f14eagle/redox-keyboard/redox-f14/#test.dxf

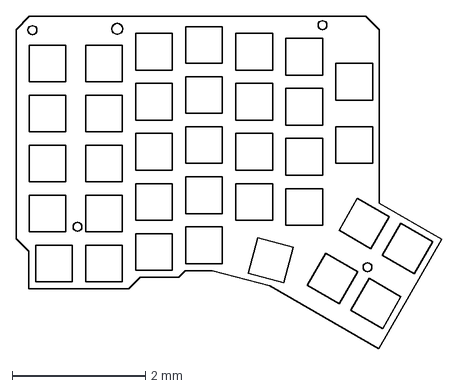
[picture p1: CAD file, 2019-10-26]
redox-f14/#test.dxf
6.38 x 4.98 mm
