f14eagle/redox-keyboard/redox-f14/case/#wingxx-case-rev2.dxf

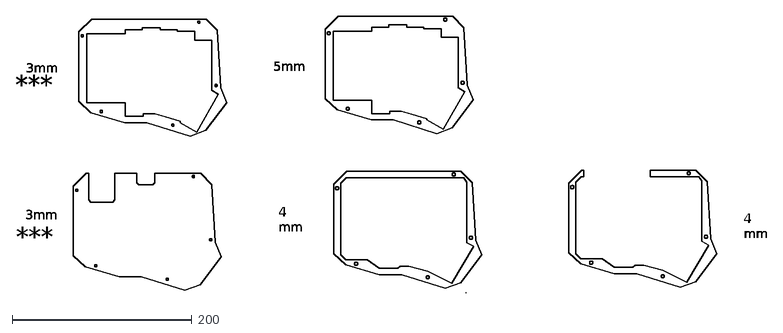
[picture p2: CAD file, 2020-09-10]
redox-f14/case/#wingxx-case-rev2.dxf
3mm
4 mm
5mm
***
