f14eagle/redox-keyboard/redox-f14/pcb/redox_w_transmitters_kicad_files/dxf/redox_rev1_case_v2_l1-Edge_Cuts.dxf

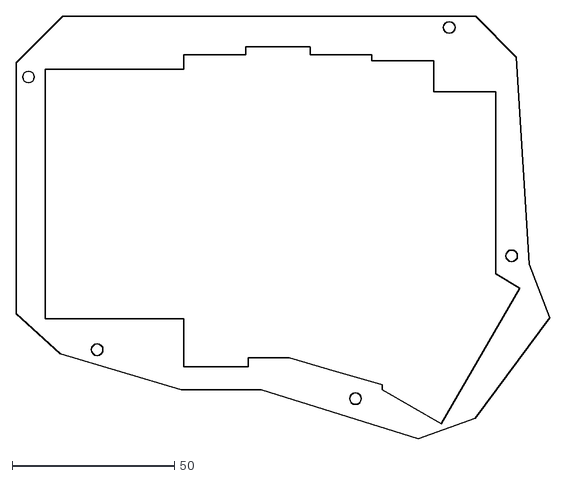
[picture p3: CAD file, 2020-03-04]
redox-f14/pcb/redox_w_transmitters_kicad_files/dxf/redox_rev1_case_v2_l1-Edge_Cuts.dxf
164.3 x 130.2
