f14eagle/redox-keyboard/redox-f14/pcb/wingxx_receiver_kicad_files_v3/dxf/wing-receiver-lite-case-Edge_Cuts.dxf

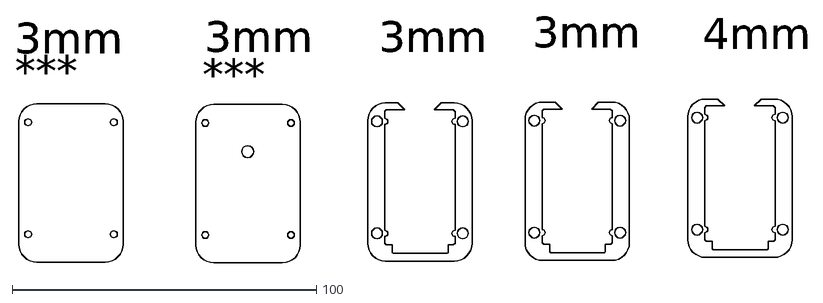
[picture p4: CAD file, 2020-09-10]
redox-f14/pcb/wingxx_receiver_kicad_files_v3/dxf/wing-receiver-lite-case-Edge_Cuts.dxf
4mm
3mm
***
