f14eagle/redox-keyboard/redox-f14/case/wingpad-case-v4.dxf

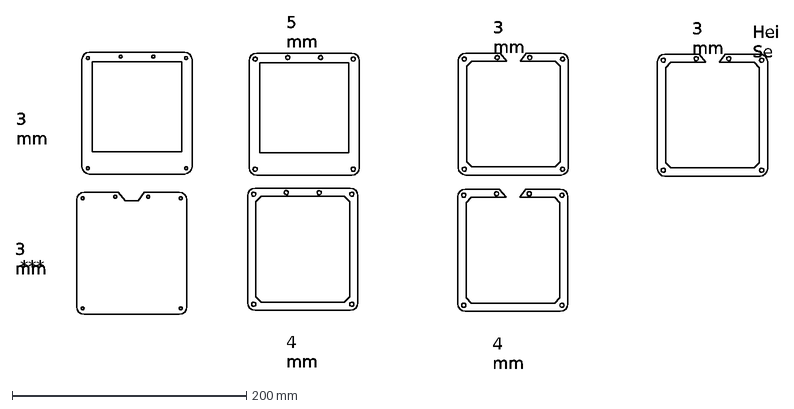
[picture p5: CAD file, 2020-05-10]
redox-f14/case/wingpad-case-v4.dxf
3 mm
5 mm
4 mm
***
Hei Se
