f14eagle/redox-keyboard/redox-f14/pcb/redox_w_transmitters_kicad_files/dxf/redox_rev1_case_l1-Edge_Cuts.dxf

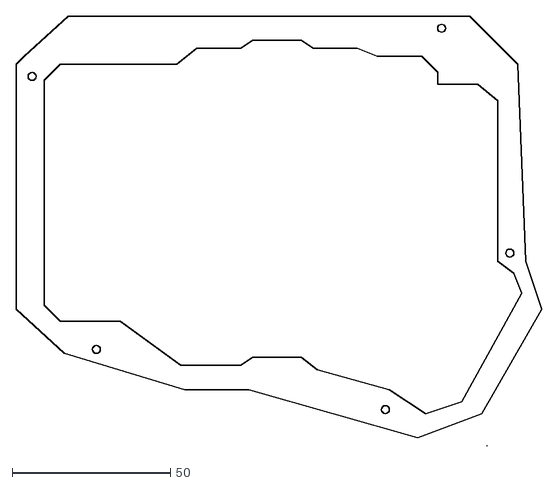
[picture p8: CAD file, 2020-02-07]
redox-f14/pcb/redox_w_transmitters_kicad_files/dxf/redox_rev1_case_l1-Edge_Cuts.dxf
166.4 x 135.9
