f14eagle/redox-keyboard/redox-f14/pcb/wingxx_receiver_kicad_files_v3/dxf/wingxx_rev3-final-case-0.4.dxf

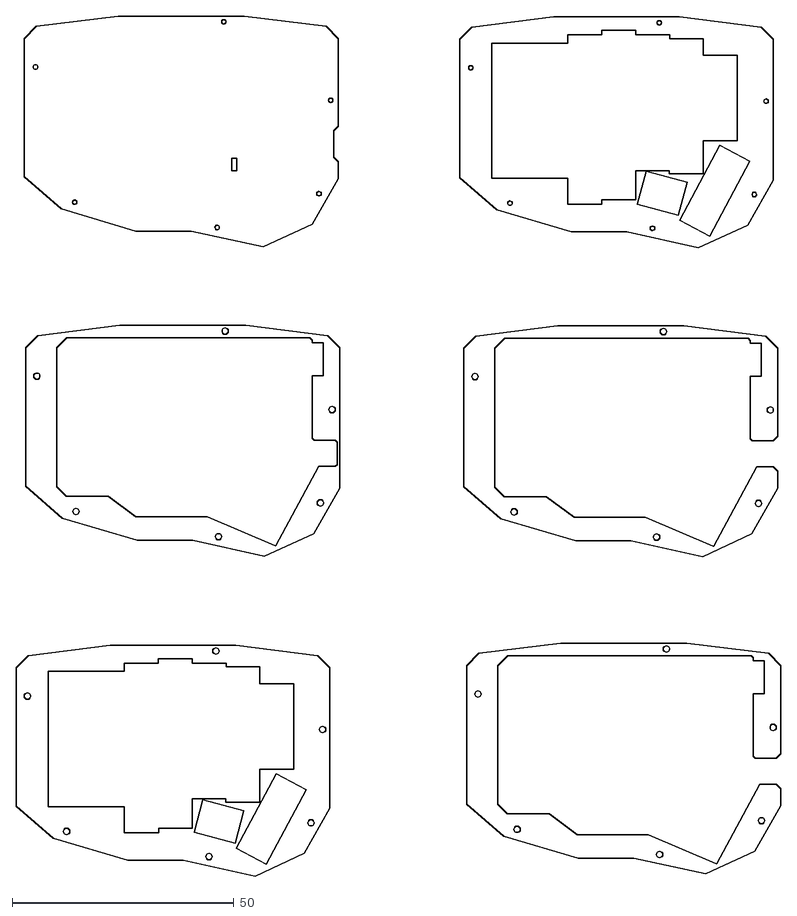
[picture p9: CAD file, 2020-05-10]
redox-f14/pcb/wingxx_receiver_kicad_files_v3/dxf/wingxx_rev3-final-case-0.4.dxf
172.4 x 193.8
