f14eagle/redox-keyboard/redox-f14/case/##wingpad-case-v2.dxf

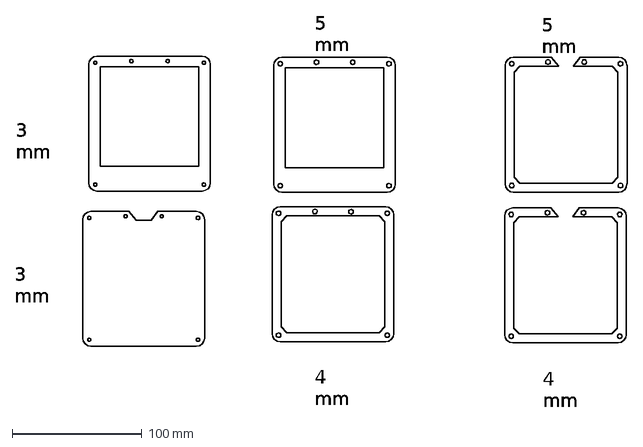
[picture p10: CAD file, 2020-03-12]
redox-f14/case/##wingpad-case-v2.dxf
3 mm
5 mm
4 mm
