f14eagle/redox-keyboard/redox-f14/pcb/wingxx_receiver_kicad_files_v3/dxf/wingxx_rev3-final-case.dxf

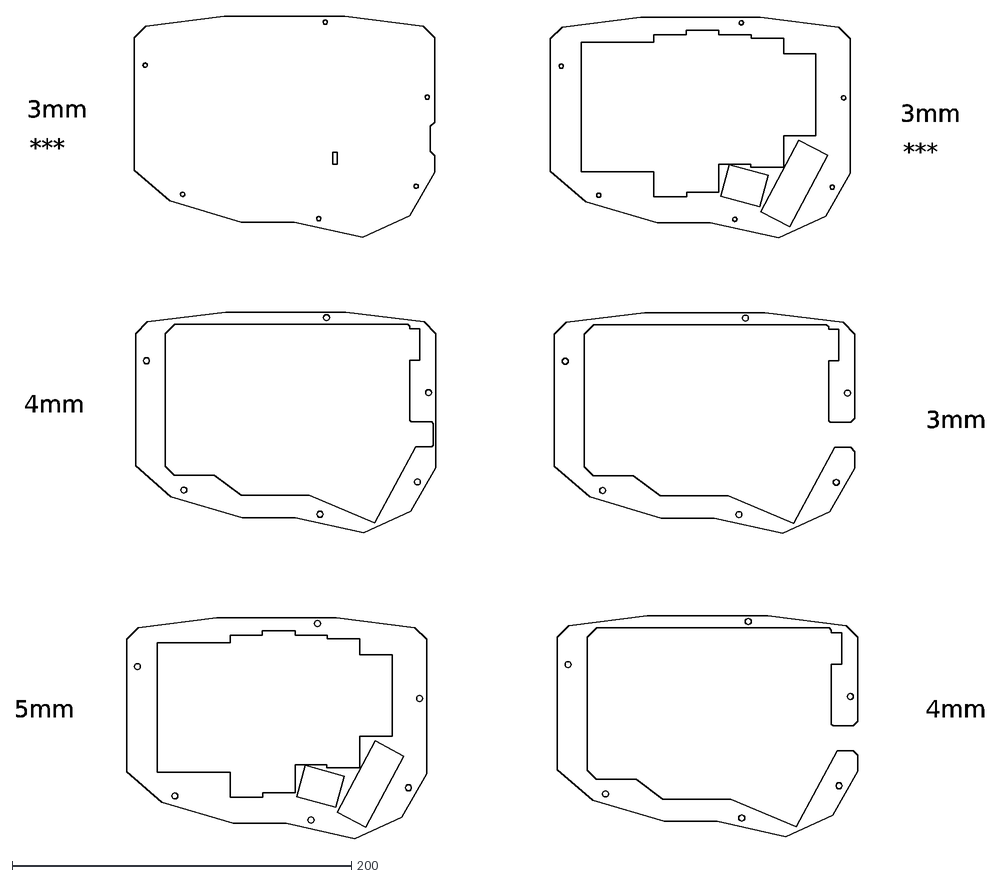
[picture p11: CAD file, 2020-05-10]
redox-f14/pcb/wingxx_receiver_kicad_files_v3/dxf/wingxx_rev3-final-case.dxf
3mm
5mm
4mm
***
