f14eagle/redox-keyboard/redox-f14/case/#wingpad-plate-v2.dxf

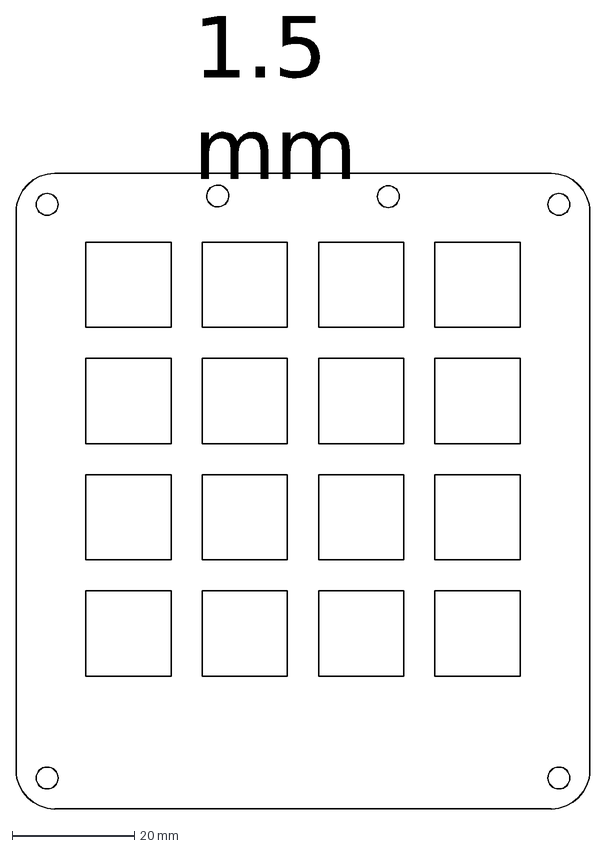
[picture p12: CAD file, 2020-02-28]
redox-f14/case/#wingpad-plate-v2.dxf
1.5 mm
