f14eagle/redox-keyboard/redox-f14/pcb/wingxx_receiver_kicad_files_v3/dxf/wingxx_rev3-final-case-0.3.dxf

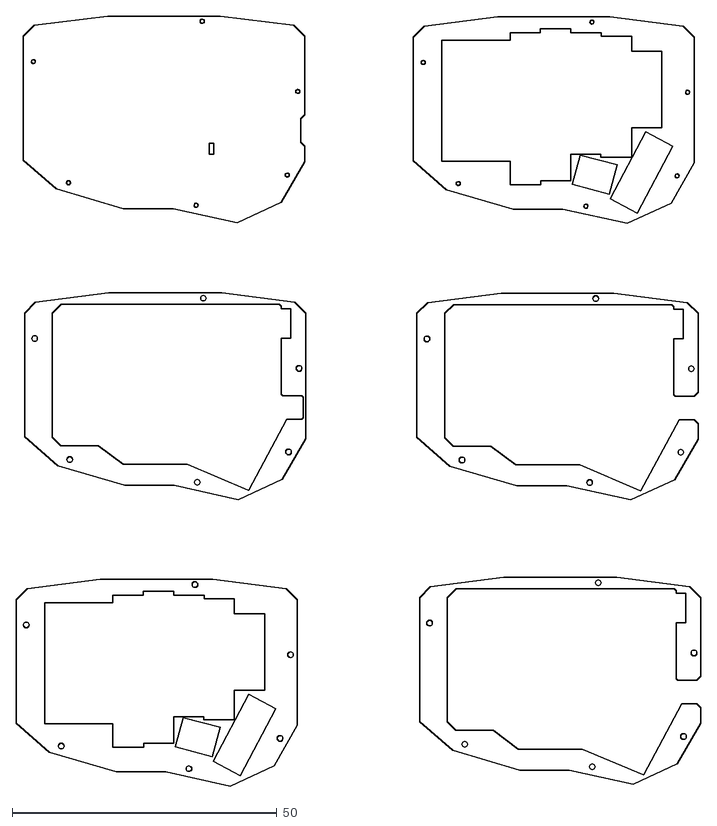
[picture p13: CAD file, 2020-05-10]
redox-f14/pcb/wingxx_receiver_kicad_files_v3/dxf/wingxx_rev3-final-case-0.3.dxf
129.3 x 145.4
