f14eagle/redox-keyboard/redox-f14/case/case-v2-l3-1.dxf

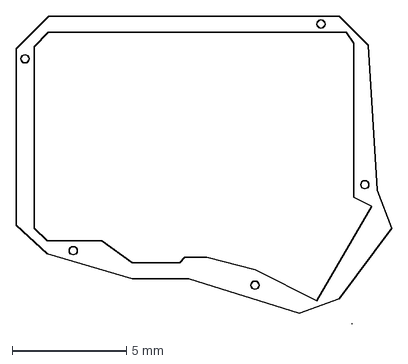
[picture p14: CAD file, 2019-12-29]
redox-f14/case/case-v2-l3-1.dxf
16.4 x 13.5 mm
