f14eagle/redox-keyboard/redox-f14/case/wingxx-plate.dxf

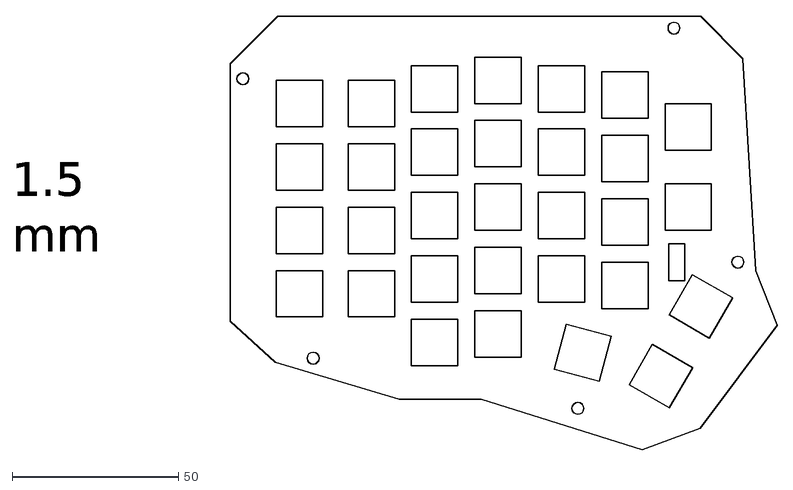
[picture p15: CAD file, 2019-12-29]
redox-f14/case/wingxx-plate.dxf
1.5 mm
