f14eagle/redox-keyboard/redox-f14/case/case-v2-l2.dxf

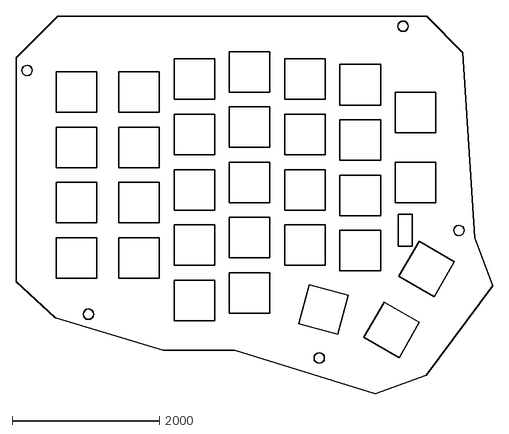
[picture p16: CAD file, 2019-11-02]
redox-f14/case/case-v2-l2.dxf
6468.7 x 5125.0
