f14eagle/redox-keyboard/redox-f14/case/case-v2-l1.dxf

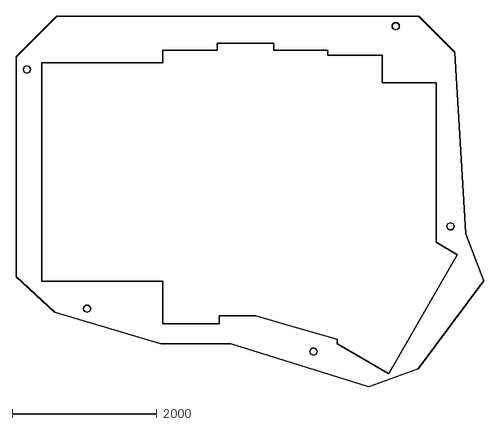
[picture p17: CAD file, 2019-11-02]
redox-f14/case/case-v2-l1.dxf
6468.7 x 5125.0
