f14eagle/redox-keyboard/redox-f14/case/f14-case-v2.dxf

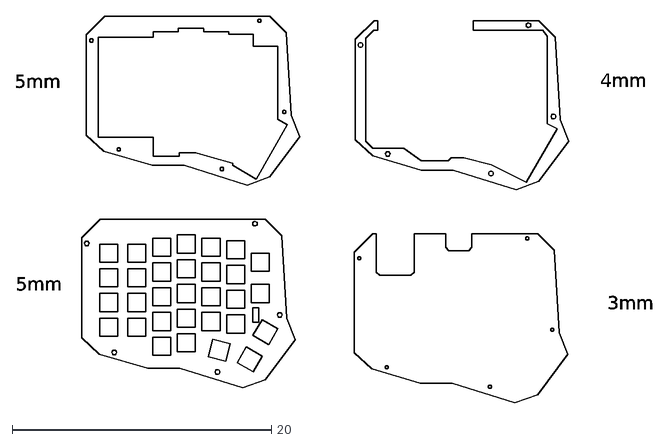
[picture p19: CAD file, 2019-11-02]
redox-f14/case/f14-case-v2.dxf
5mm
4mm
3mm
