f14eagle/redox-keyboard/redox-f14/case/#f14-case.dxf

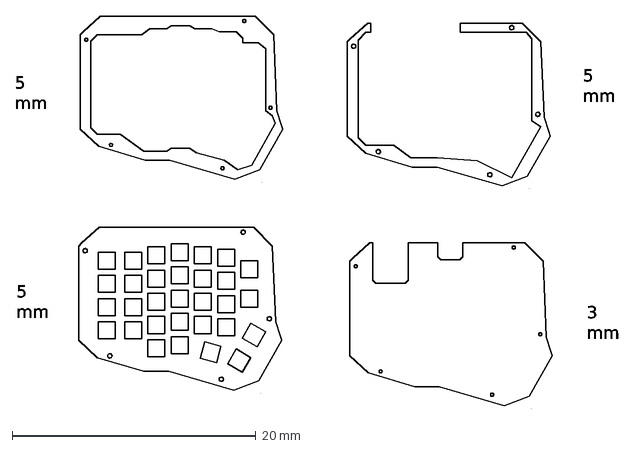
[picture p21: CAD file, 2019-11-02]
redox-f14/case/#f14-case.dxf
5 mm
3 mm
