f14eagle/redox-keyboard/redox-f14/case/RedoxWirelessRev1BottomLeft.STL

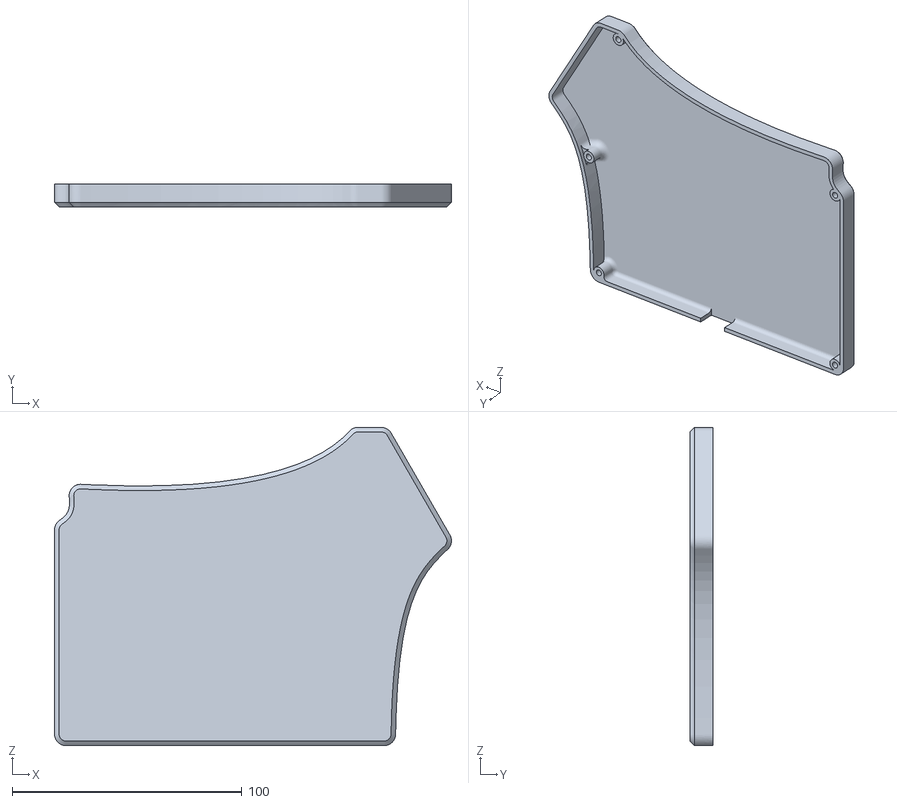
[picture p22: CAD file, 2019-10-26]
redox-f14/case/RedoxWirelessRev1BottomLeft.STL
172.6 x 10.0 x 138.4
