f14eagle/redox-keyboard/redox-f14/case/RedoxWirelessRev1TopLeft.STL

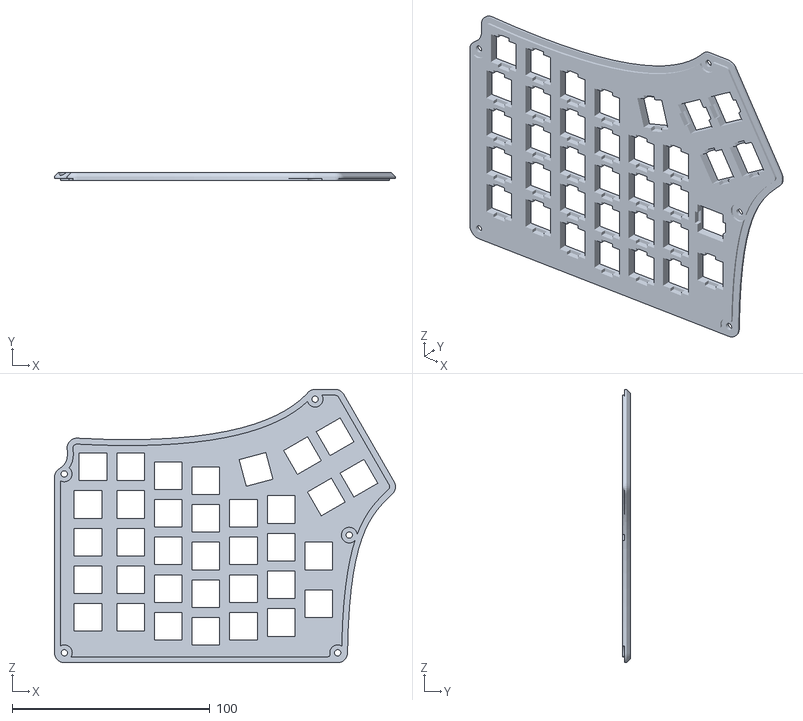
[picture p23: CAD file, 2019-10-26]
redox-f14/case/RedoxWirelessRev1TopLeft.STL
172.6 x 4.00 x 138.4
