f14eagle/redox-keyboard/(list of files, cad)

Other CAD files:
redox-f14/case/wingxx-case-ykl.dxf
redox-f14/case/RedoxWirelessRev1BottomRight.STL
redox-f14/case/RedoxWirelessRev1TopRight.STL
redox-f14/case/#wingpad-case-v2.dxf
redox-f14/case/case-l1.dxf
redox-f14/case/case-l2.dxf
redox-f14/case/case-l3.dxf
redox-f14/case/case-l4.dxf
redox-f14/case/f14-case.dxf
redox-f14/case/wingpad-case-v3.dxf
redox-f14/case/wingpad-plate-v2.dxf
redox-f14/case/wingxx-case-rev2.dxf
redox-f14/case/wingxx-case.dxf
redox-f14/pcb/wingxx_receiver_kicad_files/case/#wingpad-case.dxf
redox-f14/pcb/wingxx_receiver_kicad_files/case/wingpad-case.dxf
redox-f14/pcb/wingxx_receiver_kicad_files_v2.5/dxf/wing-receiver-lite-case-Edge_Cuts.dxf
redox-f14/pcb/wingxx_receiver_kicad_files_v2/case/#wingpad-case.dxf
redox-f14/pcb/wingxx_receiver_kicad_files_v2/case/wingpad-case.dxf
redox-f14/pcb/wingxx_receiver_kicad_files_v2/dxf/#wingxx-receiver-case-v4-plate.dxf
redox-f14/pcb/wingxx_receiver_kicad_files_v2/dxf/wingxx-receiver-case-v4-Edge_Cuts.dxf
redox-f14/pcb/wingxx_receiver_kicad_files_v2/dxf/wingxx-receiver-case-v4-case-bottom.dxf
redox-f14/pcb/wingxx_receiver_kicad_files_v2/dxf/wingxx-receiver-case-v4-case.dxf
redox-f14/pcb/wingxx_receiver_kicad_files_v2/dxf/wingxx-receiver-case-v4-case2.dxf
redox-f14/pcb/wingxx_receiver_kicad_files_v2/dxf/wingxx-receiver-case-v4-case3.dxf
redox-f14/pcb/wingxx_receiver_kicad_files_v2/dxf/wingxx-receiver-case-v4-case4.dxf
redox-f14/pcb/wingxx_receiver_kicad_files_v2/dxf/wingxx-receiver-case-v4-plate.dxf
redox-f14/pcb/wingxx_receiver_kicad_files_v2/dxf/wingxx-receiver-case-v4-plate2.dxf
redox-f14/test.dxf
