f14eagle/redox-keyboard/(list of files, drawings)

Other design files:
redox-f14/pcb/redox_w_transmitters_kicad_files/redox_rev1.dsn
redox-f14/pcb/wingxx_receiver_kicad_files/redox-receiver.dsn
redox-f14/pcb/wingxx_receiver_kicad_files_v2.5/wing-receiver-lite-rev2.dsn
redox-f14/pcb/wingxx_receiver_kicad_files_v2.5/wing-receiver-lite.dsn
redox-f14/pcb/wingxx_receiver_kicad_files_v2/redox-receiver.dsn
redox-f14/pcb/wingxx_receiver_kicad_files_v2/wingxx-receiver-v3.dsn
redox-f14/pcb/wingxx_receiver_kicad_files_v2/wingxx-receiver-v4.dsn
redox-f14/pcb/wingxx_receiver_kicad_files_v3/wing-receiver-lite.dsn
