f14eagle/redox-keyboard/redox-f14/pcb/wingxx_receiver_kicad_files_v2.5/wing-receiver-lite-rev2.kicad_pcb

## KiCad design redox-f14/pcb/wingxx_receiver_kicad_files_v2.5/wing-receiver-lite-rev2.kicad_pcb (2020-09-10, an earlier design)

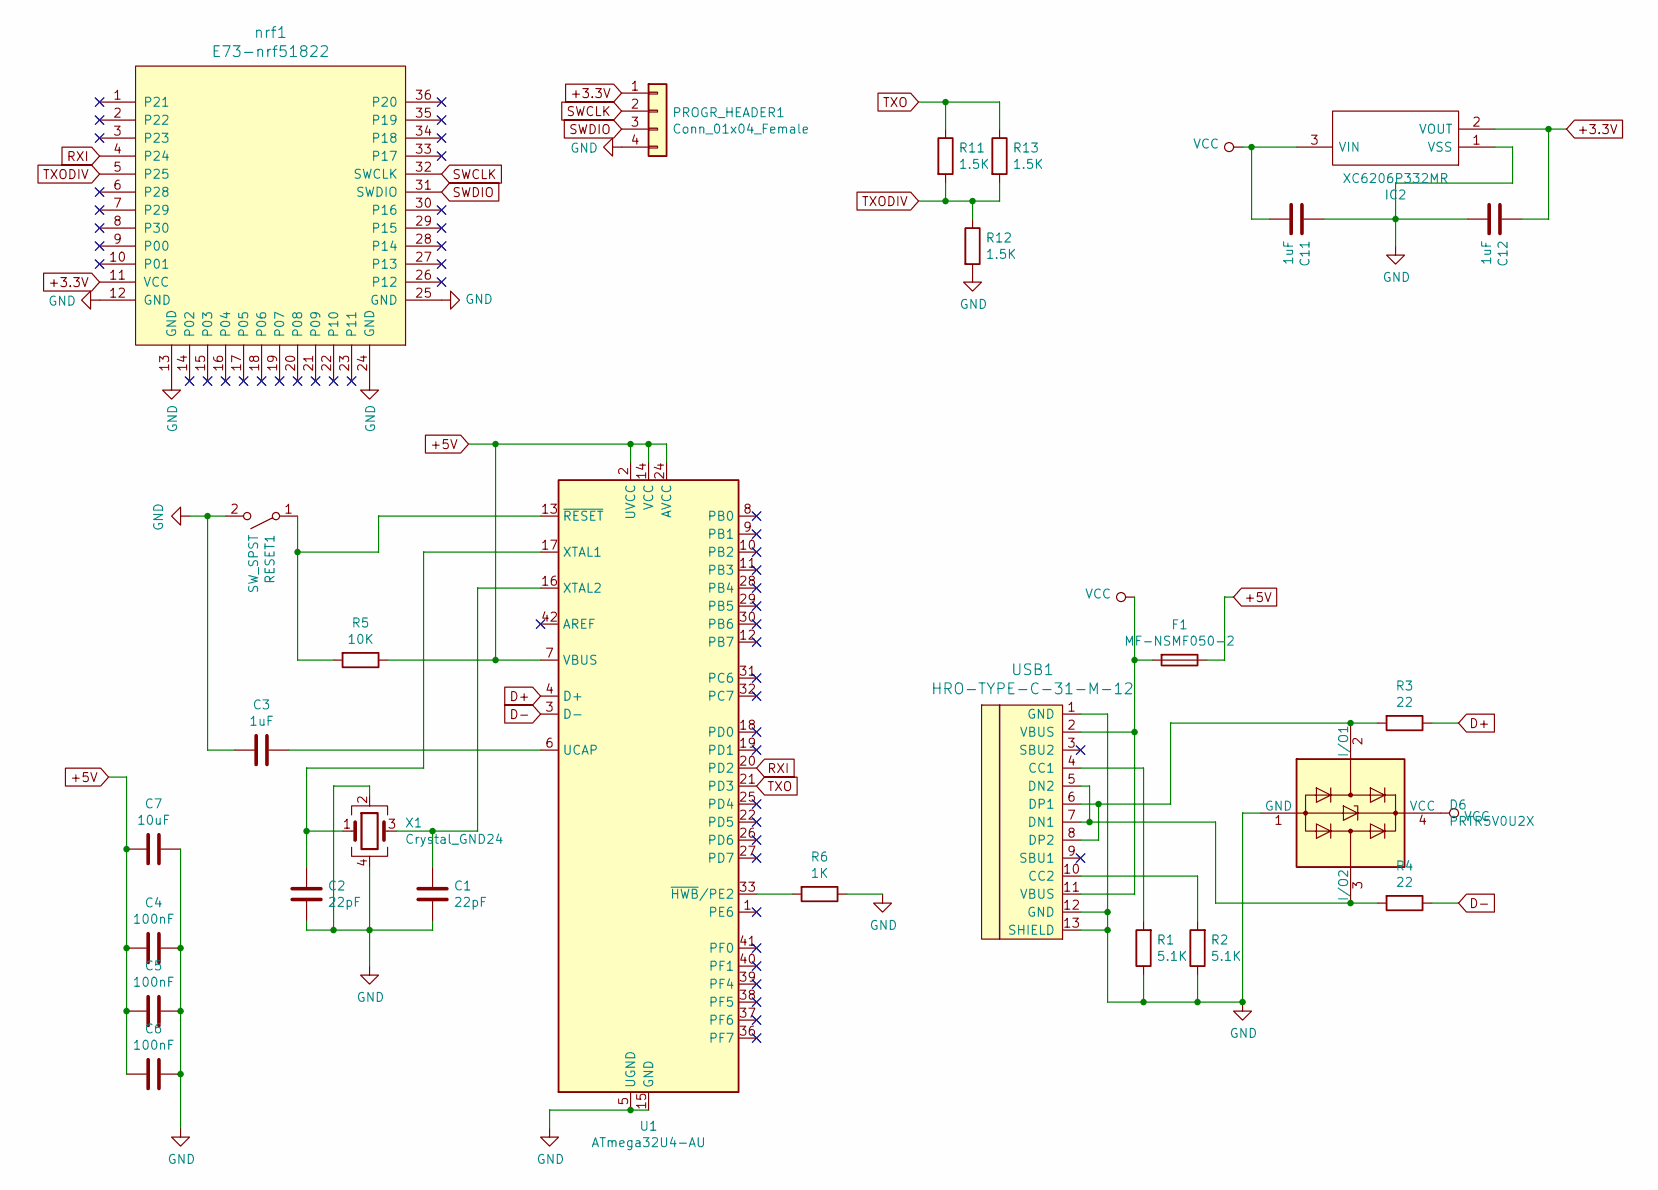
[picture p24: schematic wing-receiver-lite-rev2.sch, WingXX Receiver]

Parts:
C1, C2: 22pF; C_0805_2012Metric_Pad1.15x1.40mm_HandSolder
C3, C11, C12: 1uF; C_0805_2012Metric_Pad1.15x1.40mm_HandSolder
C4, C5, C6: 100nF; C_0805_2012Metric_Pad1.15x1.40mm_HandSolder
C7: 10uF; C_0805_2012Metric_Pad1.15x1.40mm_HandSolder
D6: PRTR5V0U2X; SOT-143
F1: MF-NSMF050-2; Fuse_1206_3216Metric_Pad1.42x1.75mm_HandSolder
IC2: XC6206P332MR; SOT95P280X130-3N; Manufacturer_Part_Number XC6206P332MR
PROGR_HEADER1: Conn_01x04_Female; PinHeader_1x04_P2.54mm_Vertical
R1, R2: 5.1K; R_0805_2012Metric_Pad1.15x1.40mm_HandSolder
R3, R4: 22; R_0805_2012Metric_Pad1.15x1.40mm_HandSolder
R5: 10K; R_0805_2012Metric_Pad1.15x1.40mm_HandSolder
R6: 1K; R_0805_2012Metric_Pad1.15x1.40mm_HandSolder
R11, R12, R13: 1.5K; R_0805_2012Metric_Pad1.15x1.40mm_HandSolder
RESET1: SW_SPST; SW_SPST_CK_RS282G05A3
U1: ATmega32U4-AU; TQFP-44_10x10mm_P0.8mm
USB1: HRO-TYPE-C-31-M-12; HRO-TYPE-C-f14
X1: Crystal_GND24; Crystal_SMD_3225-4Pin_3.2x2.5mm_HandSoldering
nrf1: E73-nrf51822; E73-nrf51822-Module

Connections:
+3.3V: C12.1, IC2.2 (VOUT), PROGR_HEADER1.1, nrf1.11 (VCC)
+5V: C4.2, C5.2, C6.2, C7.2, F1.1, R5.1, U1.2 (UVCC), U1.7 (VBUS), U1.14 (VCC), U1.24 (AVCC), U1.34 (VCC), U1.44 (AVCC)
D+: R3.1, U1.4 (D+)
D-: R4.1, U1.3 (D-)
GND: C1.2, C2.2, C3.2, C4.1, C5.1, C6.1, C7.1, C11.1, C12.2, D6.1 (GND), IC2.1 (VSS), PROGR_HEADER1.4, R1.1, R2.1, R6.1, R12.2, RESET1.2 (B), U1.5 (UGND), U1.15 (GND), U1.23 (GND), U1.35 (GND), U1.43 (GND), USB1.1 (GND), USB1.12 (GND), USB1.13 (SHIELD), X1.2, X1.4, nrf1.12 (GND), nrf1.13 (GND), nrf1.24 (GND), nrf1.25 (GND)
unnamed: C1.1, U1.16 (XTAL2), X1.3
unnamed: C2.1, U1.17 (XTAL1), X1.1
unnamed: C3.1, U1.6 (UCAP)
unnamed: D6.2 (I/O1), R3.2, USB1.6 (DP1), USB1.8 (DP2)
unnamed: D6.3 (I/O2), R4.2, USB1.5 (DN2), USB1.7 (DN1)
unnamed: R1.2, USB1.4 (CC1)
unnamed: R2.2, USB1.10 (CC2)
unnamed: R5.2, RESET1.1 (A), U1.13 (~RESET)
unnamed: R6.2, U1.33 (~HWB~/PE2)
RXI: U1.20 (PD2), nrf1.4 (P24)
SWCLK: PROGR_HEADER1.2, nrf1.32 (SWCLK)
SWDIO: PROGR_HEADER1.3, nrf1.31 (SWDIO)
TXO: R11.1, R13.1, U1.21 (PD3)
TXODIV: R11.2, R12.1, R13.2, nrf1.5 (P25)
VCC: C11.2, D6.4 (VCC), F1.2, IC2.3 (VIN), USB1.2 (VBUS), USB1.11 (VBUS)

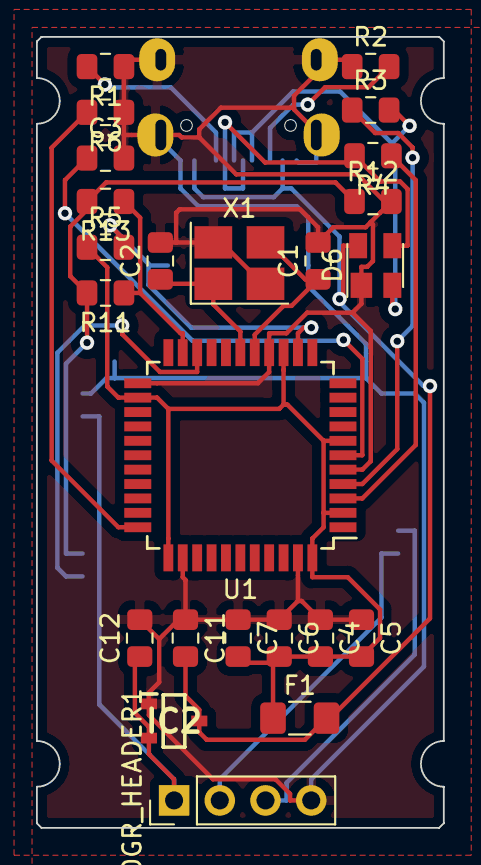
[picture p25: board wing-receiver-lite-rev2.kicad_pcb from above]

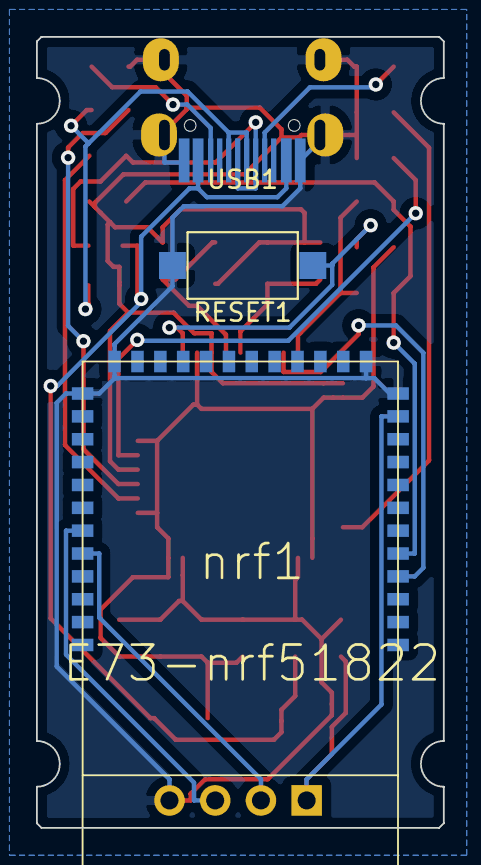
[picture p26: board wing-receiver-lite-rev2.kicad_pcb from below]

Board: 2 copper layers, 22.6 x 43.9 mm, 27 parts (3 on the bottom side), 20 nets.
