f14eagle/redox-keyboard/redox-w/pcb/redox_w_transmitters_kicad_files/redox_rev1.kicad_pcb

## KiCad design redox-w/pcb/redox_w_transmitters_kicad_files/redox_rev1.kicad_pcb (2019-10-26)

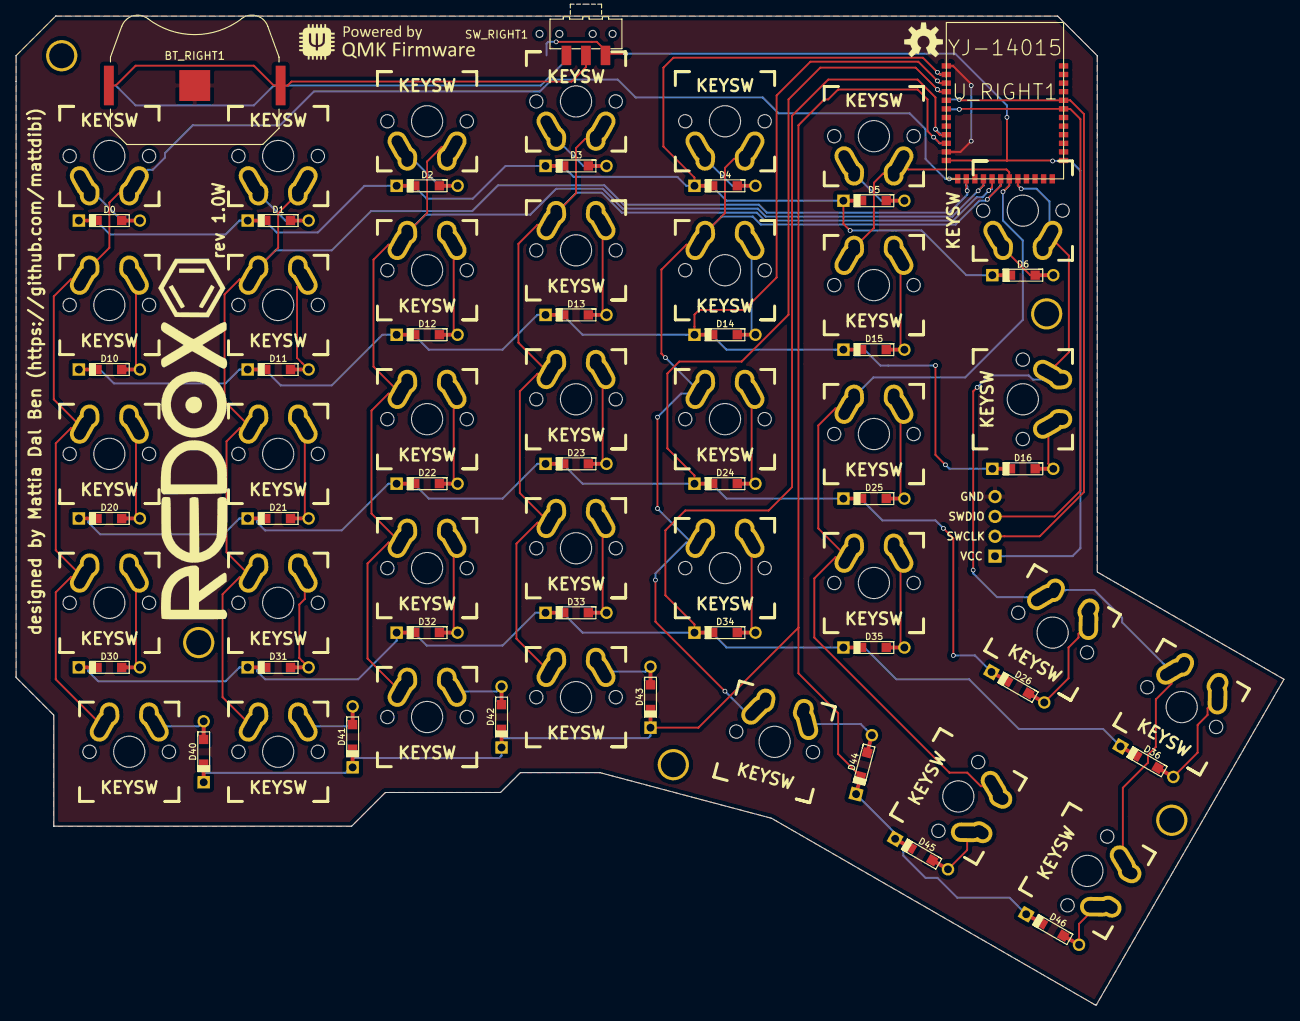
[picture p27: board redox_rev1.kicad_pcb from above]

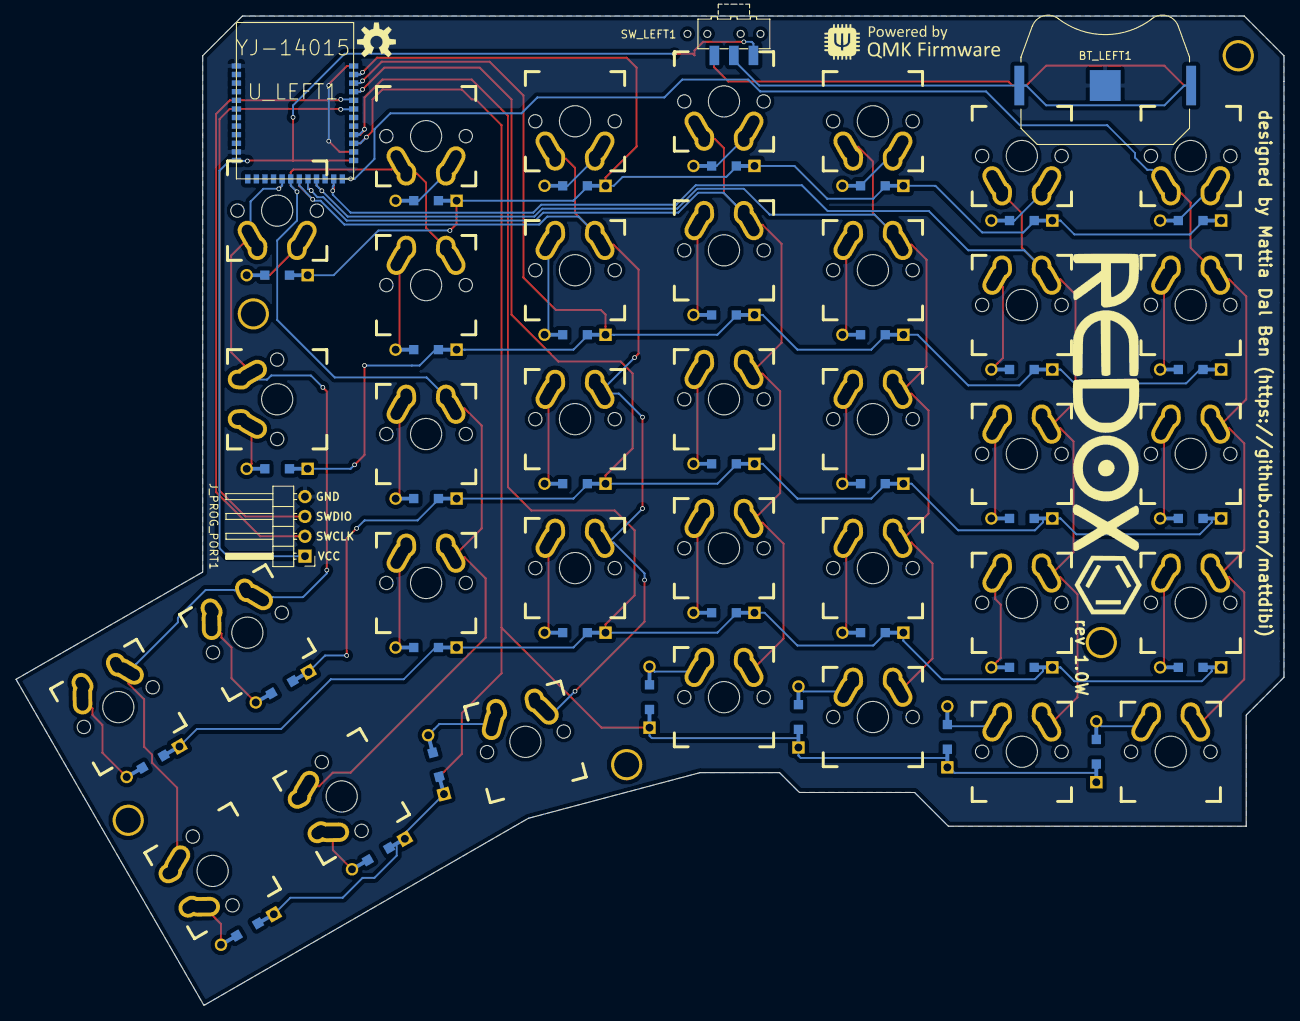
[picture p28: board redox_rev1.kicad_pcb from below]

Board: 2 copper layers, 162.2 x 126.5 mm, 82 parts (4 on the bottom side), 53 nets.

Parts:
BT_LEFT1: Battery_Cell; BatteryHolder_Keystone_3034_1x20mm
BT_RIGHT1: Battery_Cell; BatteryHolder_Keystone_3034_1x20mm
D0, D1, D2, D3, D4, D5, D6, D10, D11, D12, D13, D14, D15, D16, D20, D21, D22, D23, D24, D25, D26, D30, D31, D32, D33, D34, D35, D36, D40, D41, D42, D43, D44, D45, D46: D; Diode-dual
HOLE_M3, HOLE_M3#2, HOLE_M3#3, HOLE_M3#4, HOLE_M3#5: VAL**; HOLE_M3
J_PROG_PORT1: Conn_01x04_Male; PinHeader_1x04_P2.54mm_Horizontal
K0, K10, K20, K30, K44: KEYSW; Mx_Alps_125-dualside
K1, K2, K3, K4, K5, K6, K11, K12, K13, K14, K15, K21, K22, K23, K24, K25, K26, K31, K32, K33, K34, K35, K36, K40, K41, K42, K43: KEYSW; Mx_Alps_100-dualside
K16, K45, K46: KEYSW; Mx_Alps_150-dualsided
SW_LEFT1: SW_SPDT; SW_SPDT_CK-JS102011SAQN
SW_RIGHT1: SW_SPDT; SW_SPDT_CK-JS102011SAQN
U_LEFT1: YJ-14015; MY-YJ-14015-Module
U_RIGHT1: YJ-14015; MY-YJ-14015-Module

Connections:
GND: BT_LEFT1.2, BT_RIGHT1.2, J_PROG_PORT1.4, U_LEFT1.1, U_LEFT1.11, U_RIGHT1.1, U_RIGHT1.11
unnamed: BT_LEFT1.1, SW_LEFT1.2
unnamed: BT_RIGHT1.1, SW_RIGHT1.2
unnamed: D0.2, K0.2
unnamed: D1.2, K1.2
unnamed: D2.2, K2.2
unnamed: D3.2, K3.2
unnamed: D4.2, K4.2
unnamed: D5.2, K5.2
unnamed: D6.2, K6.2
unnamed: D10.2, K10.2
unnamed: D11.2, K11.2
unnamed: D12.2, K12.2
unnamed: D13.2, K13.2
unnamed: D14.2, K14.2
unnamed: D15.2, K15.2
unnamed: D16.2, K16.2
unnamed: D20.2, K20.2
unnamed: D21.2, K21.2
unnamed: D22.2, K22.2
unnamed: D23.2, K23.2
unnamed: D24.2, K24.2
unnamed: D25.2, K25.2
unnamed: D26.2, K26.2
unnamed: D30.2, K30.2
unnamed: D31.2, K31.2
unnamed: D32.2, K32.2
unnamed: D33.2, K33.2
unnamed: D34.2, K34.2
unnamed: D35.2, K35.2
unnamed: D36.2, K36.2
unnamed: D40.2, K40.2
unnamed: D41.2, K41.2
unnamed: D42.2, K42.2
unnamed: D43.2, K43.2
unnamed: D44.2, K44.2
unnamed: D45.2, K45.2
unnamed: D46.2, K46.2
SWCLK: J_PROG_PORT1.2, U_LEFT1.32, U_RIGHT1.32
SWDIO: J_PROG_PORT1.3, U_LEFT1.31, U_RIGHT1.31
VCC: J_PROG_PORT1.1, SW_LEFT1.1, SW_RIGHT1.1, U_LEFT1.12, U_RIGHT1.12
col0: K0.1, K10.1, K20.1, K30.1, K40.1, U_LEFT1.24, U_RIGHT1.13
col1: K1.1, K11.1, K21.1, K31.1, K41.1, U_LEFT1.23, U_RIGHT1.14
col2: K2.1, K12.1, K22.1, K32.1, K42.1, U_LEFT1.21, U_RIGHT1.16
col3: K3.1, K13.1, K23.1, K33.1, K43.1, U_LEFT1.20, U_RIGHT1.17
col4: K4.1, K14.1, K24.1, K34.1, K44.1, U_LEFT1.19, U_RIGHT1.18
col5: K5.1, K15.1, K25.1, K35.1, K45.1, U_LEFT1.18, U_RIGHT1.19
col6: K6.1, K16.1, K26.1, K36.1, K46.1, U_LEFT1.17, U_RIGHT1.20
row0: D0.1, D1.1, D2.1, D3.1, D4.1, D5.1, D6.1, U_LEFT1.35, U_RIGHT1.2
row1: D10.1, D11.1, D12.1, D13.1, D14.1, D15.1, D16.1, U_LEFT1.34, U_RIGHT1.3
row2: D20.1, D21.1, D22.1, D23.1, D24.1, D25.1, D26.1, U_LEFT1.33, U_RIGHT1.4
row3: D30.1, D31.1, D32.1, D33.1, D34.1, D35.1, D36.1, U_LEFT1.28, U_RIGHT1.9
row4: D40.1, D41.1, D42.1, D43.1, D44.1, D45.1, D46.1, U_LEFT1.27, U_RIGHT1.10
