f14eagle/redox-keyboard/redox-f14/pcb/wingxx_receiver_kicad_files_v2/wingxx-receiver.kicad_pcb

## KiCad design redox-f14/pcb/wingxx_receiver_kicad_files_v2/wingxx-receiver.kicad_pcb (2020-01-07, an earlier design)

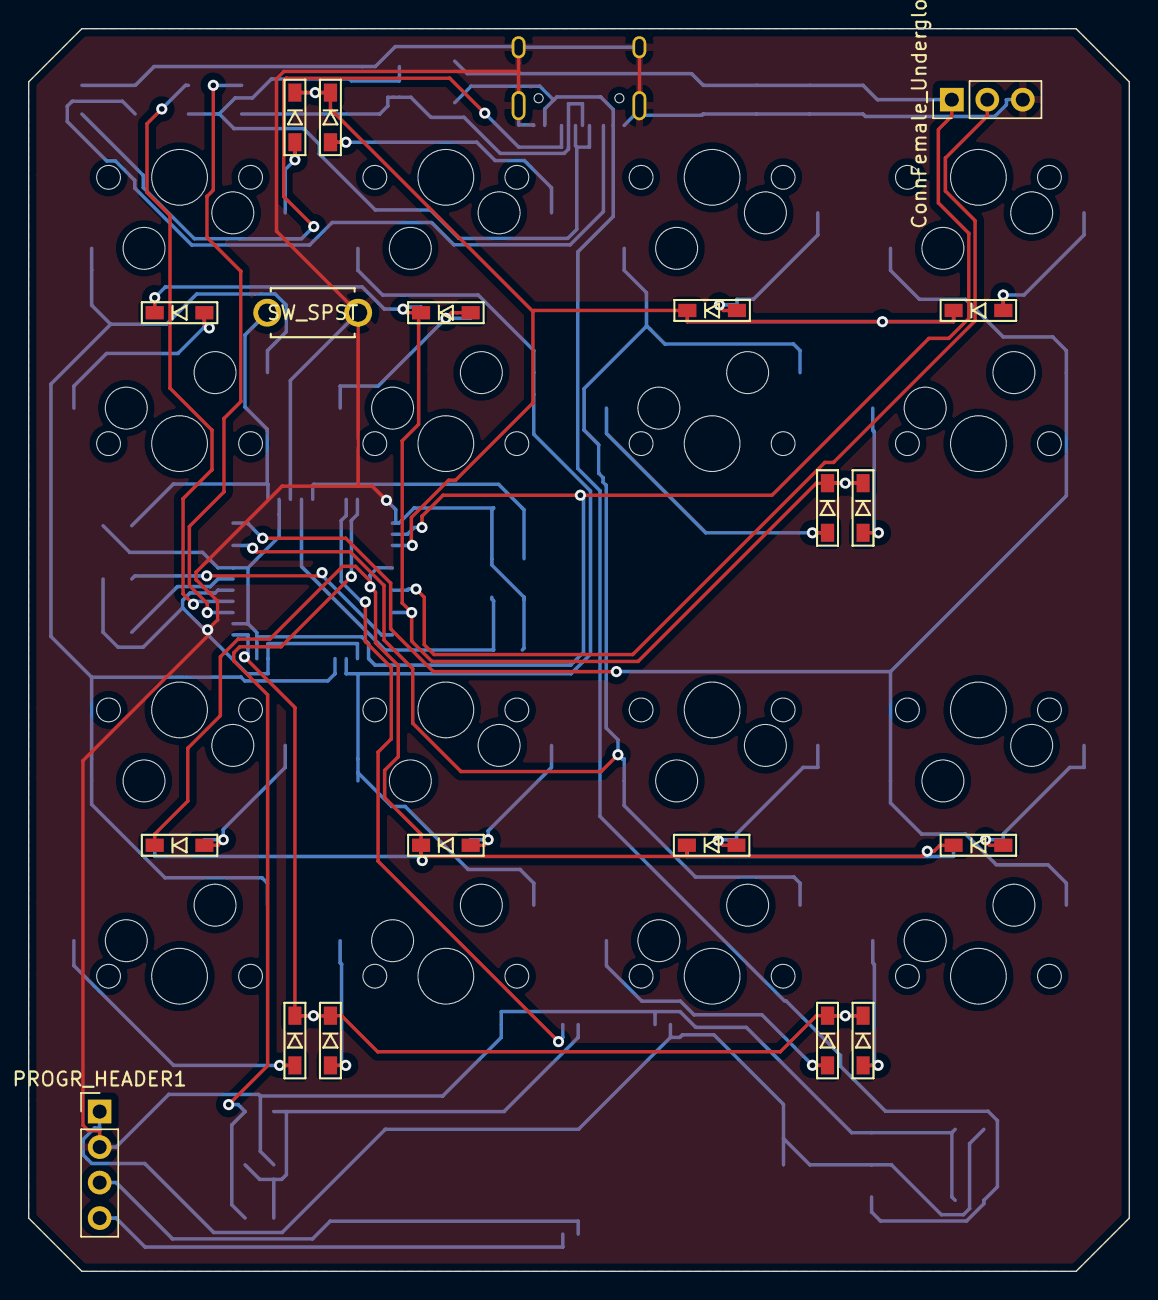
[picture p29: board wingxx-receiver.kicad_pcb from above]

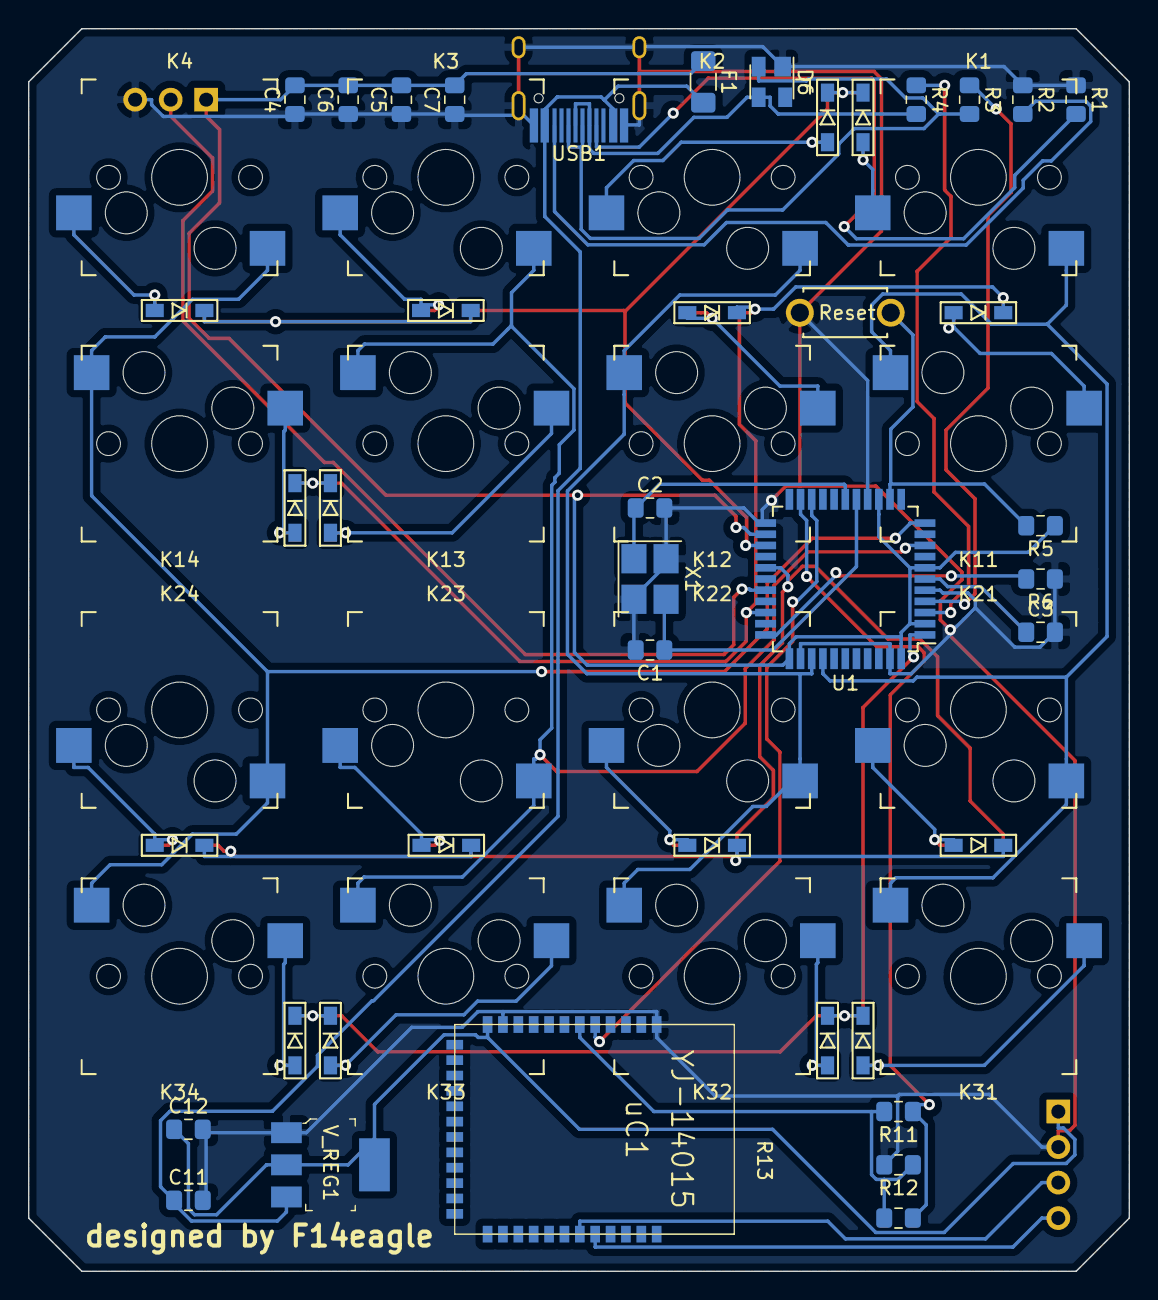
[picture p30: board wingxx-receiver.kicad_pcb from below]

Board: 2 copper layers, 78.7 x 88.9 mm, 60 parts (25 on the bottom side), 45 nets.

Parts:
C1, C2: 22pF; C_0805_2012Metric_Pad1.15x1.40mm_HandSolder
C3: 1uF; C_0805_2012Metric_Pad1.15x1.40mm_HandSolder
C4, C5, C6: 100nF; C_0805_2012Metric_Pad1.15x1.40mm_HandSolder
C7, C11, C12: 10uF; C_0805_2012Metric_Pad1.15x1.40mm_HandSolder
ConnFemale_Underglow1: Conn_01x03_Female; PinHeader_1x03_P2.54mm_Vertical
D1, D2, D3, D4, D11, D12, D13, D14, D21, D22, D23, D24, D31, D32, D33, D34: D; D3_SMD
D6: PRTR5V0U2X; SOT-143
F1: MF-NSMF050-2; Fuse_1206_3216Metric_Pad1.42x1.75mm_HandSolder
K1, K2, K3, K4, K11, K12, K13, K14, K21, K22, K23, K24, K31, K32, K33, K34: KEYSW-redox_rev1-rescue; Kailh_socket
PROGR_HEADER1: Conn_01x04_Female; PinHeader_1x04_P2.54mm_Vertical
R1, R2: 5.1K; R_0805_2012Metric_Pad1.15x1.40mm_HandSolder
R3, R4: 22; R_0805_2012Metric_Pad1.15x1.40mm_HandSolder
R5: 10K; R_0805_2012Metric_Pad1.15x1.40mm_HandSolder
R6: 1K; R_0805_2012Metric_Pad1.15x1.40mm_HandSolder
R11, R12, R13: 1.5K; R_0805_2012Metric_Pad1.15x1.40mm_HandSolder
RESET1: SW_SPST; ResetSW
U1: ATmega32U4-AU; TQFP-44_10x10mm_P0.8mm
USB1: HRO-TYPE-C-31-M-12; HRO-TYPE-C-31-M-12-HandSoldering
V_REG1: LD1117S33CTR; SOT-223
X1: Crystal_GND24; Crystal_SMD_3225-4Pin_3.2x2.5mm_HandSoldering
uC1: YJ-14015; MY-YJ-14015-Module

Connections:
+3.3V: C12.1, PROGR_HEADER1.1, V_REG1.2, V_REG1.4, uC1.12
+5V: C4.2, C5.2, C6.2, C7.2, ConnFemale_Underglow1.1, F1.1, R5.1, U1.2, U1.7, U1.14, U1.24, U1.34, U1.44
D+: R3.1, U1.4
D-: R4.1, U1.3
GND: C1.2, C2.2, C3.2, C4.1, C5.1, C6.1, C7.1, C11.2, C12.2, ConnFemale_Underglow1.3, D6.1, PROGR_HEADER1.2, R1.1, R2.1, R6.1, R12.2, RESET1.2, U1.5, U1.15, U1.23, U1.35, U1.43, USB1.1, USB1.12, USB1.13, V_REG1.1, X1.2, X1.4, uC1.1, uC1.11
unnamed: C1.1, U1.16, X1.3
unnamed: C2.1, U1.17, X1.1
unnamed: C3.1, U1.6
unnamed: D1.2, K1.2
unnamed: D2.2, K2.2
unnamed: D3.2, K3.2
unnamed: D4.2, K4.2
unnamed: D6.2, R3.2, USB1.6, USB1.8
unnamed: D6.3, R4.2, USB1.5, USB1.7
unnamed: D11.2, K11.2
unnamed: D12.2, K12.2
unnamed: D13.2, K13.2
unnamed: D14.2, K14.2
unnamed: D21.2, K21.2
unnamed: D22.2, K22.2
unnamed: D23.2, K23.2
unnamed: D24.2, K24.2
unnamed: D31.2, K31.2
unnamed: D32.2, K32.2
unnamed: D33.2, K33.2
unnamed: D34.2, K34.2
unnamed: R1.2, USB1.4
unnamed: R2.2, USB1.10
unnamed: R5.2, RESET1.1, U1.13
unnamed: R6.2, U1.33
RGB_DATA: ConnFemale_Underglow1.2, U1.29
RXI: U1.20, uC1.5
SWCLK: PROGR_HEADER1.4, uC1.32
SWDIO: PROGR_HEADER1.3, uC1.31
TXO: R11.1, R13.1, U1.21
TXODIV: R11.2, R12.1, R13.2, uC1.6
VCC: C11.1, F1.2, USB1.2, USB1.11, V_REG1.3
col0: K1.1, K11.1, K21.1, K31.1, U1.37
col1: K2.1, K12.1, K22.1, K32.1, U1.36
col2: K3.1, K13.1, K23.1, K33.1, U1.9
col3: K4.1, K14.1, K24.1, K34.1, U1.11
row0: D1.1, D2.1, D3.1, D4.1, U1.25
row1: D11.1, D12.1, D13.1, D14.1, U1.31
row2: D21.1, D22.1, D23.1, D24.1, U1.27
row3: D31.1, D32.1, D33.1, D34.1, U1.1
