f14eagle/redox-keyboard/(commit log)

2019-10-26 update my pcb
    [#test.dxf, RedoxWirelessRev1BottomLeft.STL, RedoxWirelessRev1BottomRight.STL, RedoxWirelessRev1TopLeft.STL, RedoxWirelessRev1TopRight.STL, redox_rev1-2018-08-25-11-09-09.sch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]
2019-10-26 completed rathalos keyboard
    [redox_rev1.dsn, redox_rev1_routed.kicad_pcb, redox_rev1_routed2.kicad_pcb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]
2019-10-26 add edge cut
    [redox_rev1_routed4_case.kicad_pcb]
2019-10-27 add case files
    [case-l1.dxf, case-l2.dxf, case-l3.dxf, case-l4.dxf, f14-case.dxf, redox_rev1_case_l1.kicad_pcb, redox_rev1_case_l2.kicad_pcb, redox_rev1_case_l3.kicad_pcb]
2019-11-02 update case v2
    [#f14-case.dxf, case-v2-l1.dxf, case-v2-l2.dxf, case-v2-l3.dxf, case-v2-l4.dxf, f14-case-v2.dxf, redox_rev1_case_v2_l1.kicad_pcb, redox_rev1_case_v2_l2.kicad_pcb]
2019-12-29 add new receiver
    [case-v2-l3-1.dxf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]
2020-01-07 add wing pad
    [#wingpad-case-v2.dxf, #wingpad-case.dxf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]
2020-01-14 update wingxx receiver v2
    [redox-receiver.dsn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]
2020-01-16 update v3 v4 receiver
    [redox-receiver-B_Cu.gbr, redox-receiver-B_Mask.gbr, redox-receiver-B_Paste.gbr, redox-receiver-B_SilkS.gbr, redox-receiver-Edge_Cuts.gbr, redox-receiver-F_Cu.gbr, redox-receiver-F_Mask.gbr, redox-receiver-F_Paste.gbr]
2020-01-23 add new receiver case v4
    [redox_rev1.kicad_pcb, wingxx-receiver-case-v4.kicad_pcb]
2020-02-07 new receiver
    [redox_rev1_case_l1-Edge_Cuts.dxf, redox_rev1_case_v3_l1-Edge_Cuts.dxf, redox_rev1_case_v3_l1.kicad_pcb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]
2020-03-04 wingxx case update
    [redox_rev1_case_v2_l1-Edge_Cuts.dxf, redox_rev1_case_v2_l1.kicad_pcb, wingxx-case-rev2.dxf]
2020-03-12 update pad case
    [##wingpad-case-v2.dxf, wingxx-receiver-case-v4-case.dxf, wingxx-receiver-case-v4-case2.dxf, wingxx-receiver-case-v4-plate.dxf, wingxx-receiver-case-v4-plate2.dxf]
2020-05-10 update to new style
    [wing-receiver-lite-Bottom_Cu.gbr, wing-receiver-lite-Bottom_Mask.gbr, wing-receiver-lite-Bottom_Paste.gbr, wing-receiver-lite-Bottom_Silk.gbr, wing-receiver-lite-EdgeCuts.gbr, wing-receiver-lite-NPTH.drl, wing-receiver-lite-PTH.drl, wing-receiver-lite-Top_Cu.gbr]
2020-05-10 add receiver v2.5
    [#wingxx-receiver-case-v4-plate.dxf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]
2021-04-11 sync to remote
    [wing-receiver-lite-rev2-Bottom_Cu.gbr, wing-receiver-lite-rev2-Bottom_Mask.gbr, wing-receiver-lite-rev2-Bottom_Paste.gbr, wing-receiver-lite-rev2-Bottom_Silk.gbr, wing-receiver-lite-rev2-EdgeCuts.gbr, wing-receiver-lite-rev2-NPTH.drl, wing-receiver-lite-rev2-PTH.drl, wing-receiver-lite-rev2-Top_Cu.gbr]
